TDuke94/plant-health-camera-hardware/kicad/csi-mux/csi-mux.kicad_sch

## KiCad design kicad/csi-mux/csi-mux.kicad_sch (2026-10-25)

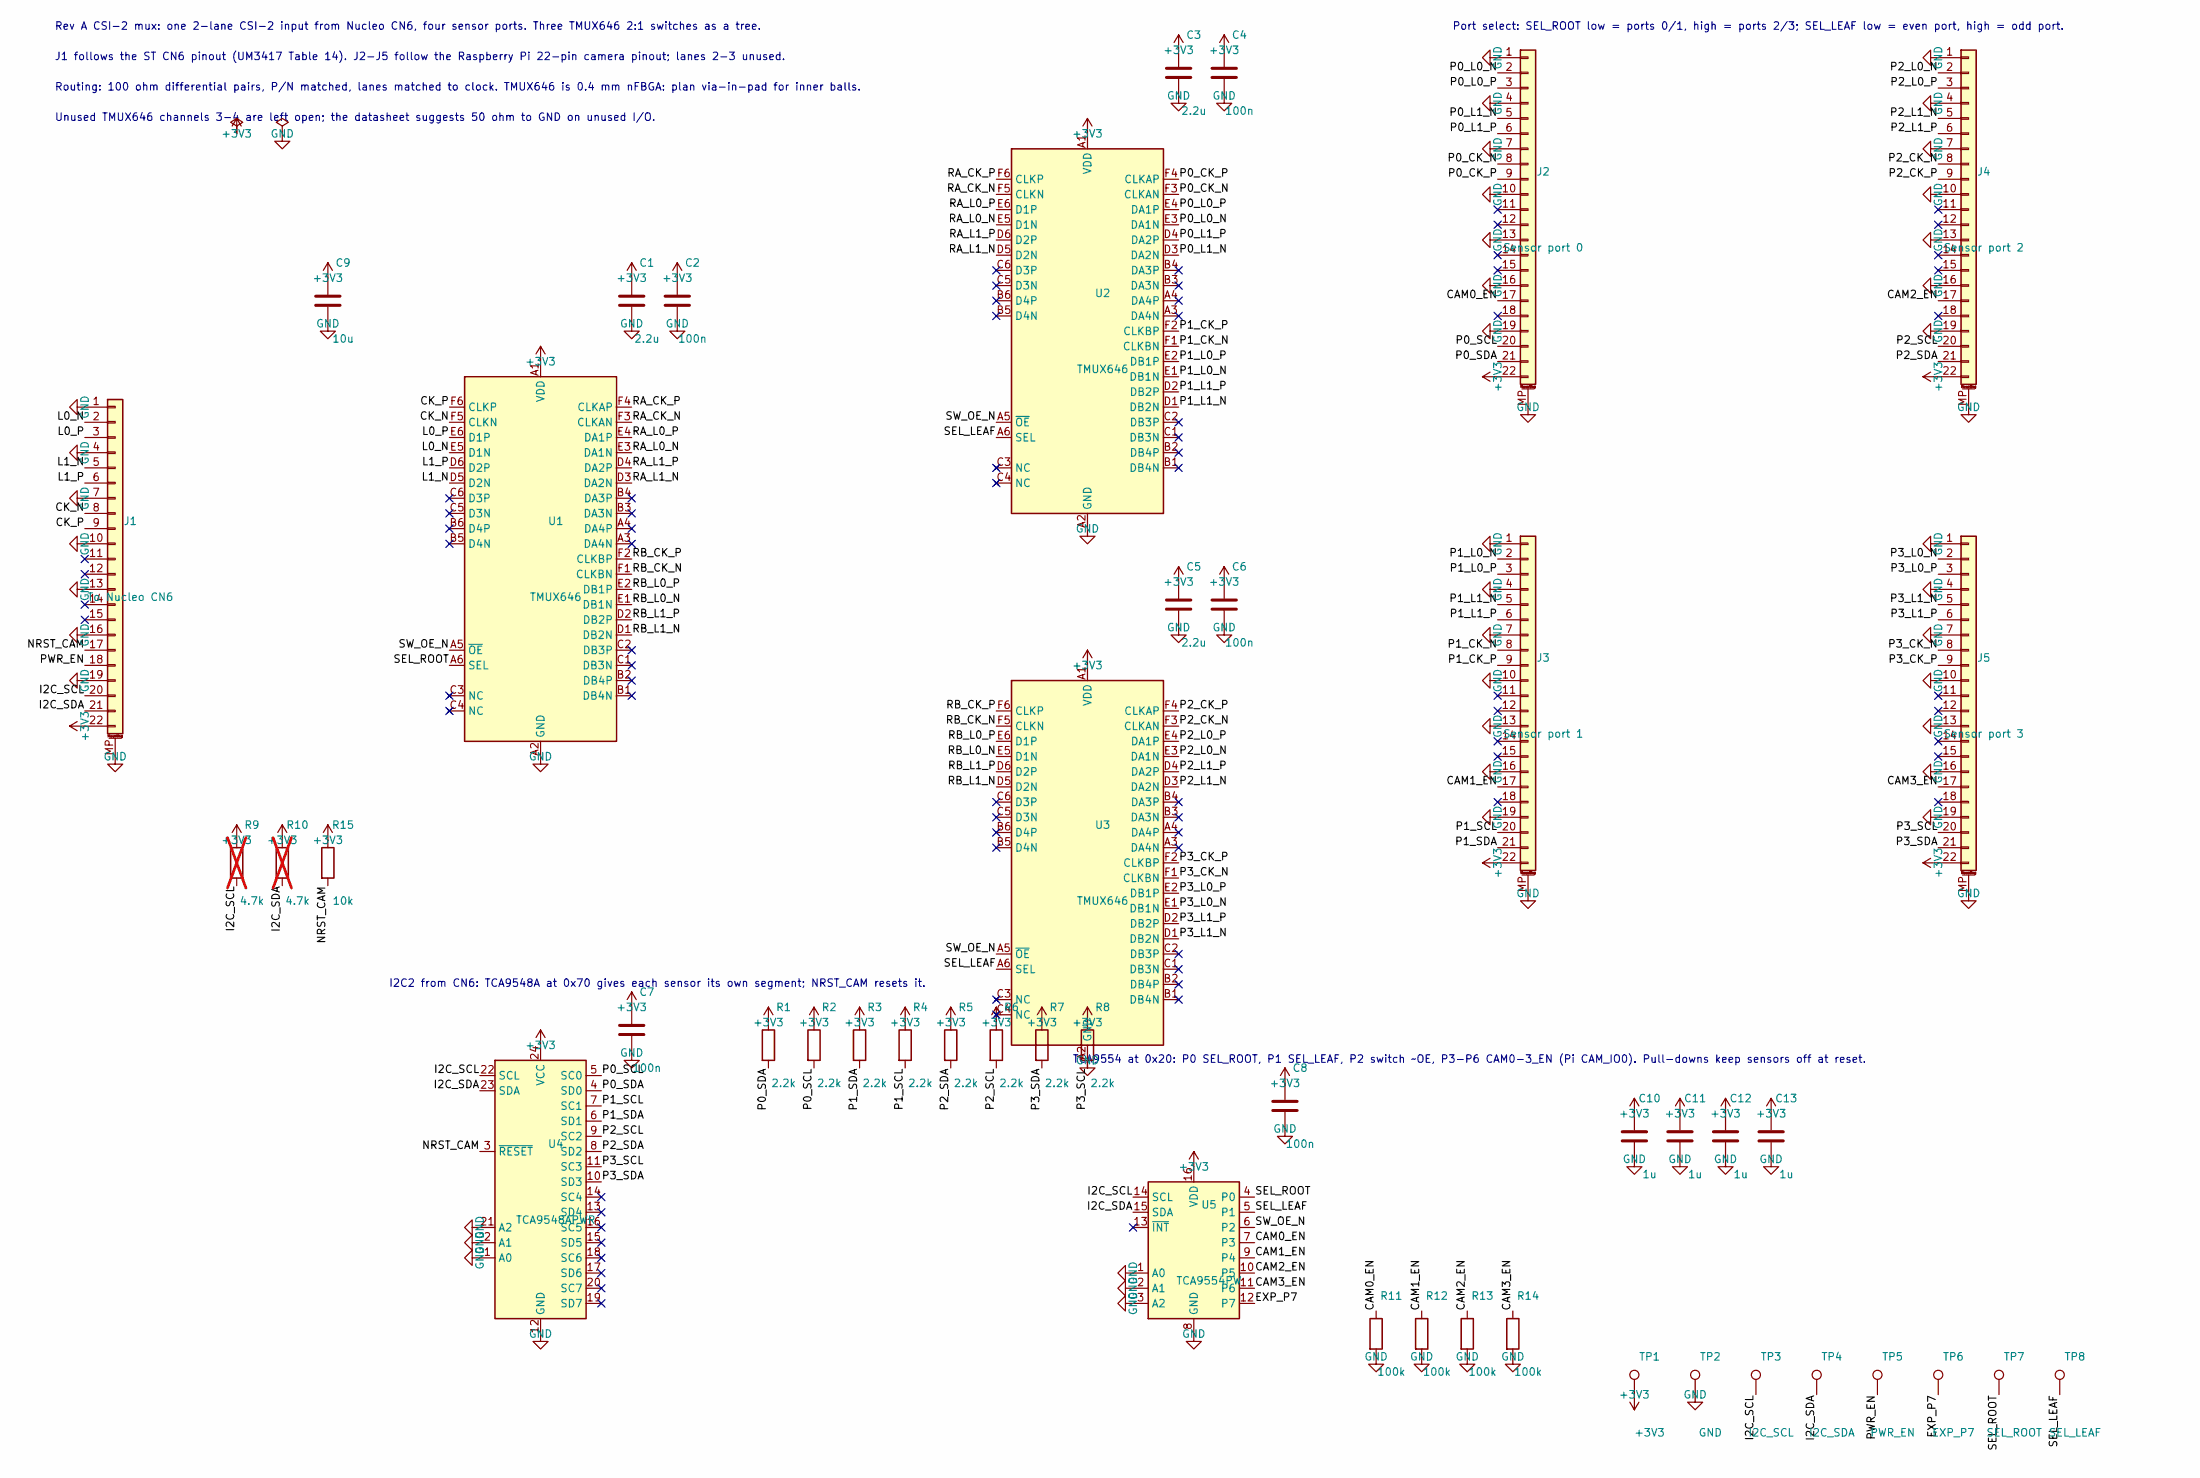
[picture p1: schematic csi-mux.kicad_sch]

Parts:
C1, C3, C5: 2.2u; C_0603_1608Metric
C2, C4, C6, C7, C8: 100n; C_0603_1608Metric
C9: 10u; C_0805_2012Metric
C10, C11, C12, C13: 1u; C_0603_1608Metric
J1: To Nucleo CN6; Hirose_FH12-22S-0.5SH_1x22-1MP_P0.50mm_Horizontal
J2: Sensor port 0; Hirose_FH12-22S-0.5SH_1x22-1MP_P0.50mm_Horizontal
J3: Sensor port 1; Hirose_FH12-22S-0.5SH_1x22-1MP_P0.50mm_Horizontal
J4: Sensor port 2; Hirose_FH12-22S-0.5SH_1x22-1MP_P0.50mm_Horizontal
J5: Sensor port 3; Hirose_FH12-22S-0.5SH_1x22-1MP_P0.50mm_Horizontal
R1, R2, R3, R4, R5, R6, R7, R8: 2.2k; R_0603_1608Metric
R9, R10: 4.7k; R_0603_1608Metric; not fitted
R11, R12, R13, R14: 100k; R_0603_1608Metric
R15: 10k; R_0603_1608Metric
TP1: +3V3; TestPoint_Pad_D1.5mm
TP2: GND; TestPoint_Pad_D1.5mm
TP3: I2C_SCL; TestPoint_Pad_D1.5mm
TP4: I2C_SDA; TestPoint_Pad_D1.5mm
TP5: PWR_EN; TestPoint_Pad_D1.5mm
TP6: EXP_P7; TestPoint_Pad_D1.5mm
TP7: SEL_ROOT; TestPoint_Pad_D1.5mm
TP8: SEL_LEAF; TestPoint_Pad_D1.5mm
U1, U2, U3: TMUX646; BGA-36_3.396x3.466mm_Layout6x6_P0.4mm_Ball0.25mm_Pad0.2mm_N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
U4: TCA9548APWR; TSSOP-24_4.4x7.8mm_P0.65mm
U5: TCA9554PW; TSSOP-16_4.4x5mm_P0.65mm

Connections:
+3V3: C1.1, C2.1, C3.1, C4.1, C5.1, C6.1, C7.1, C8.1, C9.1, C10.1, C11.1, C12.1, C13.1, J1.22, J2.22, J3.22, J4.22, J5.22, R1.1, R2.1, R3.1, R4.1, R5.1, R6.1, R7.1, R8.1, R9.1, R10.1, R15.1, TP1.1, U1.A1 (VDD), U2.A1 (VDD), U3.A1 (VDD), U4.24 (VCC), U5.16 (VDD)
CAM0_EN: J2.17, R11.1, U5.7 (P3)
CAM1_EN: J3.17, R12.1, U5.9 (P4)
CAM2_EN: J4.17, R13.1, U5.10 (P5)
CAM3_EN: J5.17, R14.1, U5.11 (P6)
CK_N: J1.8, U1.F5 (CLKN)
CK_P: J1.9, U1.F6 (CLKP)
EXP_P7: TP6.1, U5.12 (P7)
GND: C1.2, C2.2, C3.2, C4.2, C5.2, C6.2, C7.2, C8.2, C9.2, C10.2, C11.2, C12.2, C13.2, J1.1, J1.4, J1.7, J1.10, J1.13, J1.16, J1.19, J1.MP (MountPin), J2.1, J2.4, J2.7, J2.10, J2.13, J2.16, J2.19, J2.MP (MountPin), J3.1, J3.4, J3.7, J3.10, J3.13, J3.16, J3.19, J3.MP (MountPin), J4.1, J4.4, J4.7, J4.10, J4.13, J4.16, J4.19, J4.MP (MountPin), J5.1, J5.4, J5.7, J5.10, J5.13, J5.16, J5.19, J5.MP (MountPin), R11.2, R12.2, R13.2, R14.2, TP2.1, U1.A2 (GND), U2.A2 (GND), U3.A2 (GND), U4.1 (A0), U4.2 (A1), U4.12 (GND), U4.21 (A2), U5.1 (A0), U5.2 (A1), U5.3 (A2), U5.8 (GND)
I2C_SCL: J1.20, R9.2, TP3.1, U4.22 (SCL), U5.14 (SCL)
I2C_SDA: J1.21, R10.2, TP4.1, U4.23 (SDA), U5.15 (SDA)
L0_N: J1.2, U1.E5 (D1N)
L0_P: J1.3, U1.E6 (D1P)
L1_N: J1.5, U1.D5 (D2N)
L1_P: J1.6, U1.D6 (D2P)
NRST_CAM: J1.17, R15.2, U4.3 (~RESET)
P0_CK_N: J2.8, U2.F3 (CLKAN)
P0_CK_P: J2.9, U2.F4 (CLKAP)
P0_L0_N: J2.2, U2.E3 (DA1N)
P0_L0_P: J2.3, U2.E4 (DA1P)
P0_L1_N: J2.5, U2.D3 (DA2N)
P0_L1_P: J2.6, U2.D4 (DA2P)
P0_SCL: J2.20, R2.2, U4.5 (SC0)
P0_SDA: J2.21, R1.2, U4.4 (SD0)
P1_CK_N: J3.8, U2.F1 (CLKBN)
P1_CK_P: J3.9, U2.F2 (CLKBP)
P1_L0_N: J3.2, U2.E1 (DB1N)
P1_L0_P: J3.3, U2.E2 (DB1P)
P1_L1_N: J3.5, U2.D1 (DB2N)
P1_L1_P: J3.6, U2.D2 (DB2P)
P1_SCL: J3.20, R4.2, U4.7 (SC1)
P1_SDA: J3.21, R3.2, U4.6 (SD1)
P2_CK_N: J4.8, U3.F3 (CLKAN)
P2_CK_P: J4.9, U3.F4 (CLKAP)
P2_L0_N: J4.2, U3.E3 (DA1N)
P2_L0_P: J4.3, U3.E4 (DA1P)
P2_L1_N: J4.5, U3.D3 (DA2N)
P2_L1_P: J4.6, U3.D4 (DA2P)
P2_SCL: J4.20, R6.2, U4.9 (SC2)
P2_SDA: J4.21, R5.2, U4.8 (SD2)
P3_CK_N: J5.8, U3.F1 (CLKBN)
P3_CK_P: J5.9, U3.F2 (CLKBP)
P3_L0_N: J5.2, U3.E1 (DB1N)
P3_L0_P: J5.3, U3.E2 (DB1P)
P3_L1_N: J5.5, U3.D1 (DB2N)
P3_L1_P: J5.6, U3.D2 (DB2P)
P3_SCL: J5.20, R8.2, U4.11 (SC3)
P3_SDA: J5.21, R7.2, U4.10 (SD3)
PWR_EN: J1.18, TP5.1
RA_CK_N: U1.F3 (CLKAN), U2.F5 (CLKN)
RA_CK_P: U1.F4 (CLKAP), U2.F6 (CLKP)
RA_L0_N: U1.E3 (DA1N), U2.E5 (D1N)
RA_L0_P: U1.E4 (DA1P), U2.E6 (D1P)
RA_L1_N: U1.D3 (DA2N), U2.D5 (D2N)
RA_L1_P: U1.D4 (DA2P), U2.D6 (D2P)
RB_CK_N: U1.F1 (CLKBN), U3.F5 (CLKN)
RB_CK_P: U1.F2 (CLKBP), U3.F6 (CLKP)
RB_L0_N: U1.E1 (DB1N), U3.E5 (D1N)
RB_L0_P: U1.E2 (DB1P), U3.E6 (D1P)
RB_L1_N: U1.D1 (DB2N), U3.D5 (D2N)
RB_L1_P: U1.D2 (DB2P), U3.D6 (D2P)
SEL_LEAF: TP8.1, U2.A6 (SEL), U3.A6 (SEL), U5.5 (P1)
SEL_ROOT: TP7.1, U1.A6 (SEL), U5.4 (P0)
SW_OE_N: U1.A5 (~OE), U2.A5 (~OE), U3.A5 (~OE), U5.6 (P2)

Notes on the sheet:
Rev A CSI-2 mux: one 2-lane CSI-2 input from Nucleo CN6, four sensor ports. Three TMUX646 2:1 switches as a tree.
J1 follows the ST CN6 pinout (UM3417 Table 14). J2-J5 follow the Raspberry Pi 22-pin camera pinout; lanes 2-3 unused.
Routing: 100 ohm differential pairs, P/N matched, lanes matched to clock. TMUX646 is 0.4 mm nFBGA: plan via-in-pad for inner balls.
Unused TMUX646 channels 3-4 are left open; the datasheet suggests 50 ohm to GND on unused I/O.
I2C2 from CN6: TCA9548A at 0x70 gives each sensor its own segment; NRST_CAM resets it.
TCA9554 at 0x20: P0 SEL_ROOT, P1 SEL_LEAF, P2 switch ~OE, P3-P6 CAM0-3_EN (Pi CAM_IO0). Pull-downs keep sensors off at reset.
Port select: SEL_ROOT low = ports 0/1, high = ports 2/3; SEL_LEAF low = even port, high = odd port.
