TDuke94/plant-health-camera-hardware/kicad/shield/shield.kicad_sch

## KiCad design kicad/shield/shield.kicad_sch (2026-10-25)

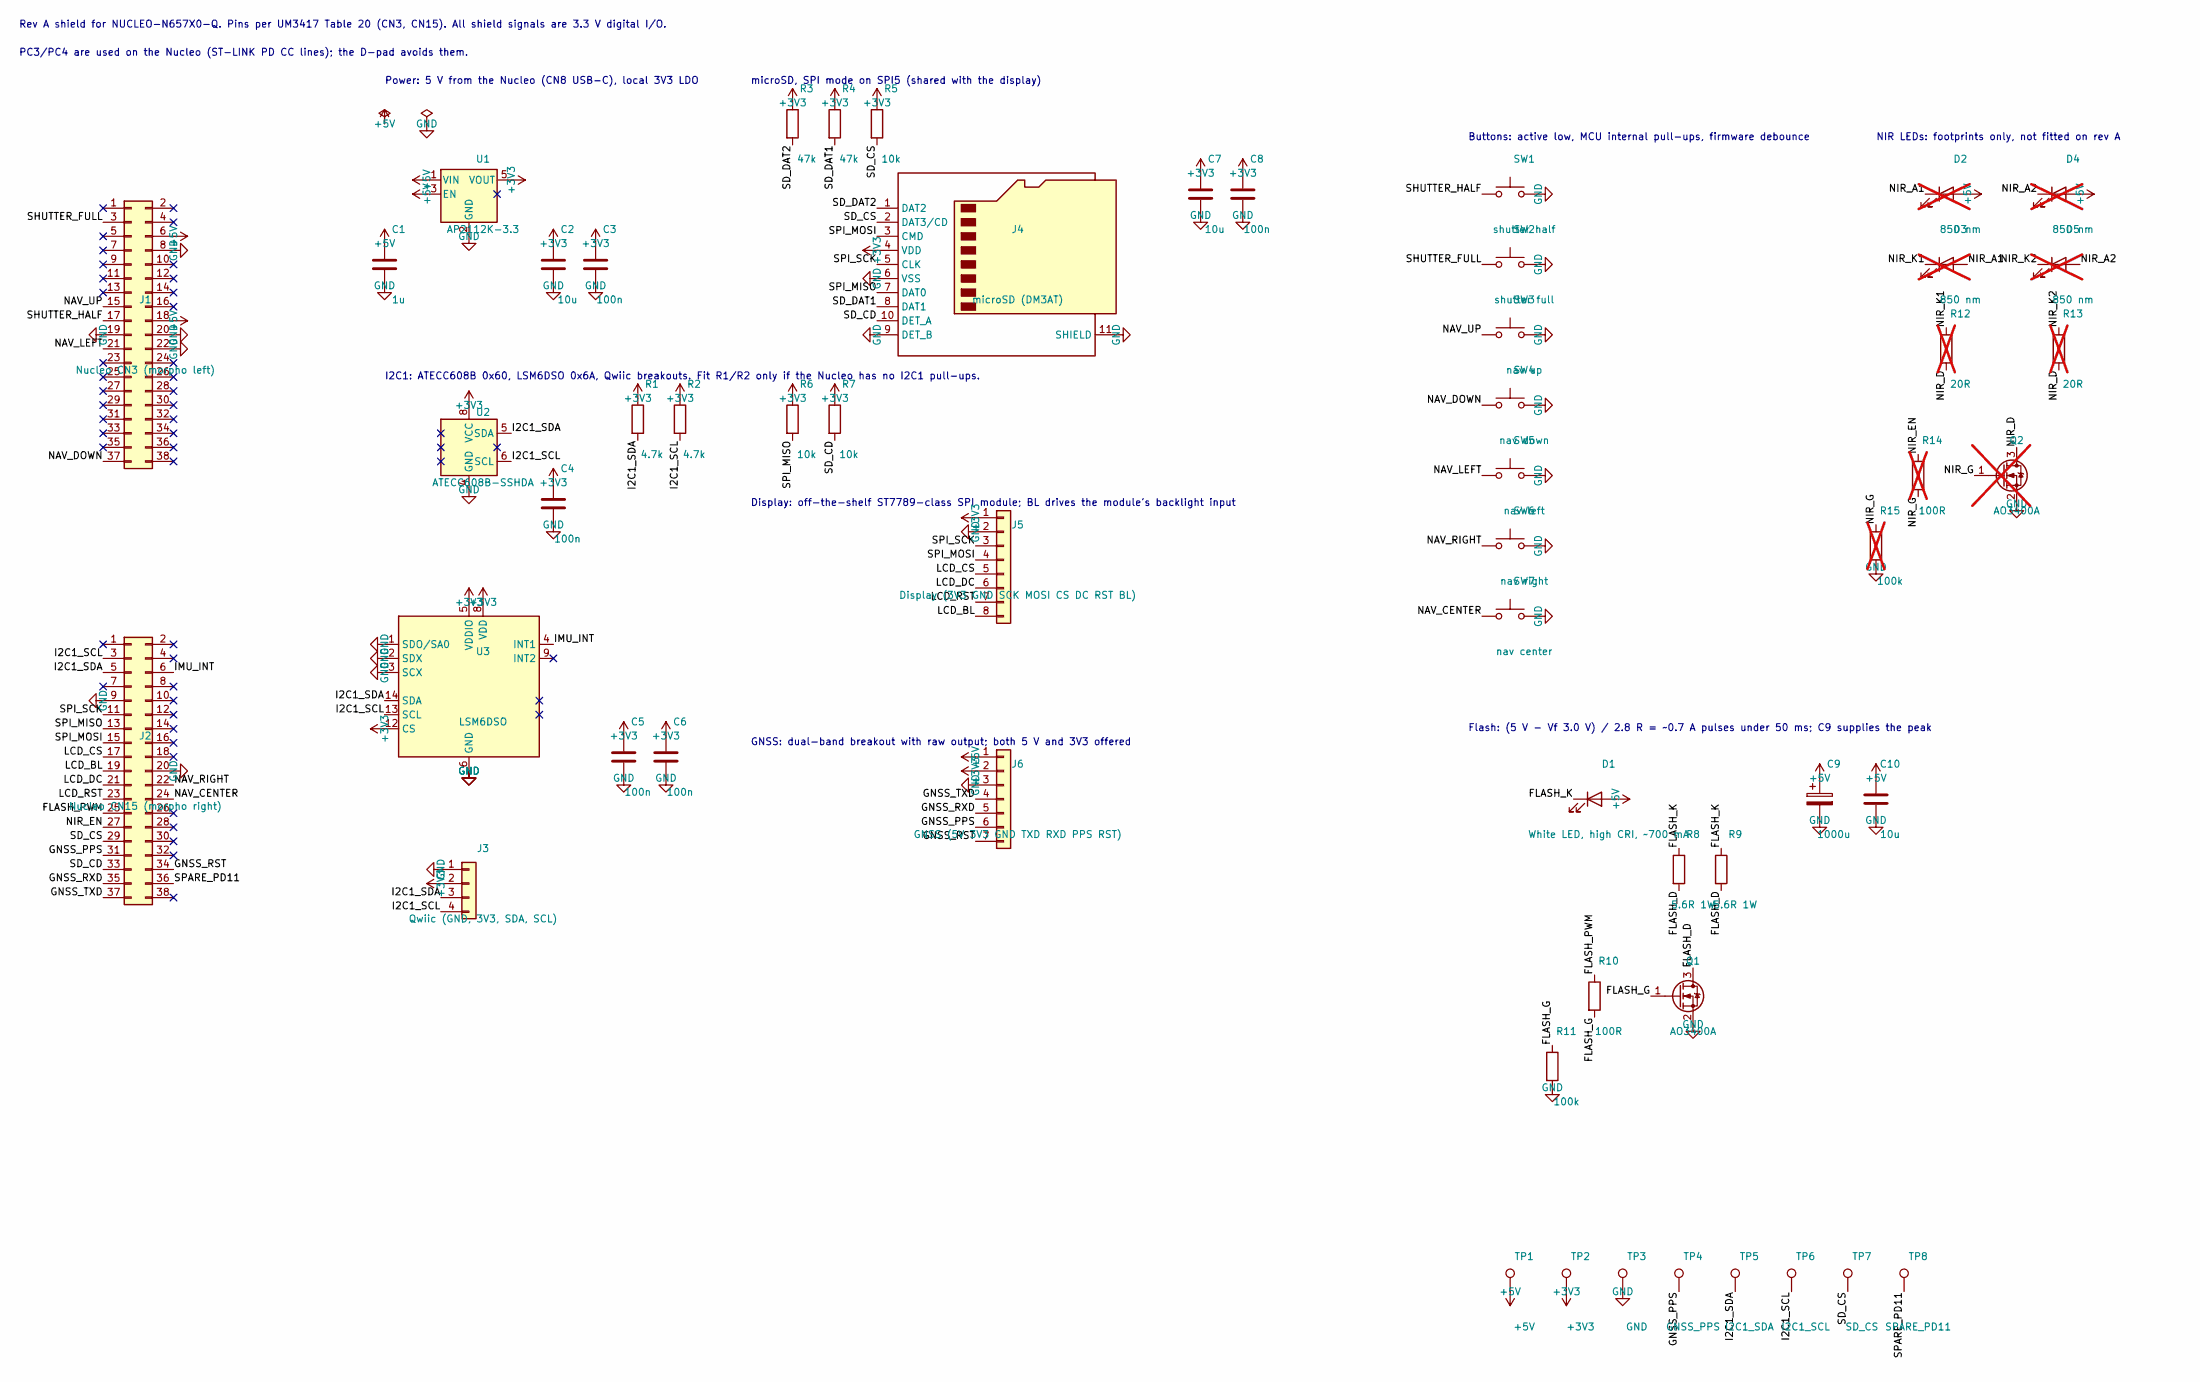
[picture p2: schematic shield.kicad_sch]

Parts:
C1: 1u; C_0603_1608Metric
C2, C7, C10: 10u; C_0805_2012Metric
C3, C4, C5, C6, C8: 100n; C_0603_1608Metric
C9: 1000u; CP_Radial_D10.0mm_P5.00mm
D1: White LED, high CRI, ~700 mA; LED_Cree-XP
D2, D3, D4, D5: 850 nm; LED_1206_3216Metric; not fitted
J1: Nucleo CN3 (morpho left); PinSocket_2x19_P2.54mm_Vertical
J2: Nucleo CN15 (morpho right); PinSocket_2x19_P2.54mm_Vertical
J3: Qwiic (GND, 3V3, SDA, SCL); JST_SH_SM04B-SRSS-TB_1x04-1MP_P1.00mm_Horizontal
J4: microSD (DM3AT); microSD_HC_Hirose_DM3AT-SF-PEJM5
J5: Display (3V3 GND SCK MOSI CS DC RST BL); PinSocket_1x08_P2.54mm_Vertical
J6: GNSS (5V 3V3 GND TXD RXD PPS RST); PinSocket_1x07_P2.54mm_Vertical
Q1: AO3400A; SOT-23
Q2: AO3400A; SOT-23; not fitted
R1, R2: 4.7k; R_0603_1608Metric
R3, R4: 47k; R_0603_1608Metric
R5, R6, R7: 10k; R_0603_1608Metric
R8, R9: 5.6R 1W; R_2512_6332Metric
R10: 100R; R_0603_1608Metric
R11: 100k; R_0603_1608Metric
R12, R13: 20R; R_0603_1608Metric; not fitted
R14: 100R; R_0603_1608Metric; not fitted
R15: 100k; R_0603_1608Metric; not fitted
SW1: shutter half; SW_SPST_TL3342
SW2: shutter full; SW_SPST_TL3342
SW3: nav up; SW_SPST_TL3342
SW4: nav down; SW_SPST_TL3342
SW5: nav left; SW_SPST_TL3342
SW6: nav right; SW_SPST_TL3342
SW7: nav center; SW_SPST_TL3342
TP1: +5V; TestPoint_Pad_D1.5mm
TP2: +3V3; TestPoint_Pad_D1.5mm
TP3: GND; TestPoint_Pad_D1.5mm
TP4: GNSS_PPS; TestPoint_Pad_D1.5mm
TP5: I2C1_SDA; TestPoint_Pad_D1.5mm
TP6: I2C1_SCL; TestPoint_Pad_D1.5mm
TP7: SD_CS; TestPoint_Pad_D1.5mm
TP8: SPARE_PD11; TestPoint_Pad_D1.5mm
U1: AP2112K-3.3; SOT-23-5
U2: ATECC608B-SSHDA; SOIC-8_3.9x4.9mm_P1.27mm
U3: LSM6DSO; LGA-14_3x2.5mm_P0.5mm_LayoutBorder3x4y

Connections:
+3V3: C2.1, C3.1, C4.1, C5.1, C6.1, C7.1, C8.1, J3.2, J4.4 (VDD), J5.1, J6.2, R1.1, R2.1, R3.1, R4.1, R5.1, R6.1, R7.1, TP2.1, U1.5 (VOUT), U2.8 (VCC), U3.5 (VDDIO), U3.8 (VDD), U3.12 (CS)
+5V: C1.1, C9.1, C10.1, D1.2 (A), D2.2 (A), D4.2 (A), J1.6, J1.18, J6.1, TP1.1, U1.1 (VIN), U1.3 (EN)
FLASH_D: Q1.3 (D), R8.2, R9.2
FLASH_G: Q1.1 (G), R10.2, R11.1
FLASH_K: D1.1 (K), R8.1, R9.1
FLASH_PWM: J2.25, R10.1
GND: C1.2, C2.2, C3.2, C4.2, C5.2, C6.2, C7.2, C8.2, C9.2, C10.2, J1.8, J1.19, J1.20, J1.22, J2.9, J2.20, J3.1, J4.6 (VSS), J4.9 (DET_B), J4.11 (SHIELD), J5.2, J6.3, Q1.2 (S), Q2.2 (S), R11.2, R15.2, SW1.2, SW2.2, SW3.2, SW4.2, SW5.2, SW6.2, SW7.2, TP3.1, U1.2 (GND), U2.4 (GND), U3.1 (SDO/SA0), U3.2 (SDX), U3.3 (SCX), U3.6 (GND), U3.7 (GND)
GNSS_PPS: J2.31, J6.6, TP4.1
GNSS_RST: J2.34, J6.7
GNSS_RXD: J2.35, J6.5
GNSS_TXD: J2.37, J6.4
I2C1_SCL: J2.3, J3.4, R2.2, TP6.1, U2.6 (SCL), U3.13 (SCL)
I2C1_SDA: J2.5, J3.3, R1.2, TP5.1, U2.5 (SDA), U3.14 (SDA)
IMU_INT: J2.6, U3.4 (INT1)
LCD_BL: J2.19, J5.8
LCD_CS: J2.17, J5.5
LCD_DC: J2.21, J5.6
LCD_RST: J2.23, J5.7
NAV_CENTER: J2.24, SW7.1
NAV_DOWN: J1.37, SW4.1
NAV_LEFT: J1.21, SW5.1
NAV_RIGHT: J2.22, SW6.1
NAV_UP: J1.15, SW3.1
NIR_A1: D2.1 (K), D3.2 (A)
NIR_A2: D4.1 (K), D5.2 (A)
NIR_D: Q2.3 (D), R12.2, R13.2
NIR_EN: J2.27, R14.1
NIR_G: Q2.1 (G), R14.2, R15.1
NIR_K1: D3.1 (K), R12.1
NIR_K2: D5.1 (K), R13.1
SD_CD: J2.33, J4.10 (DET_A), R7.2
SD_CS: J2.29, J4.2 (DAT3/CD), R5.2, TP7.1
SD_DAT1: J4.8 (DAT1), R4.2
SD_DAT2: J4.1 (DAT2), R3.2
SHUTTER_FULL: J1.3, SW2.1
SHUTTER_HALF: J1.17, SW1.1
SPARE_PD11: J2.36, TP8.1
SPI_MISO: J2.13, J4.7 (DAT0), R6.2
SPI_MOSI: J2.15, J4.3 (CMD), J5.4
SPI_SCK: J2.11, J4.5 (CLK), J5.3

Notes on the sheet:
Rev A shield for NUCLEO-N657X0-Q. Pins per UM3417 Table 20 (CN3, CN15). All shield signals are 3.3 V digital I/O.
PC3/PC4 are used on the Nucleo (ST-LINK PD CC lines); the D-pad avoids them.
Power: 5 V from the Nucleo (CN8 USB-C), local 3V3 LDO
I2C1: ATECC608B 0x60, LSM6DSO 0x6A, Qwiic breakouts. Fit R1/R2 only if the Nucleo has no I2C1 pull-ups.
microSD, SPI mode on SPI5 (shared with the display)
Display: off-the-shelf ST7789-class SPI module; BL drives the module's backlight input
GNSS: dual-band breakout with raw output; both 5 V and 3V3 offered
Buttons: active low, MCU internal pull-ups, firmware debounce
Flash: (5 V - Vf 3.0 V) / 2.8 R = ~0.7 A pulses under 50 ms; C9 supplies the peak
NIR LEDs: footprints only, not fitted on rev A
