TDuke94/plant-health-camera-hardware/(commit log)

2026-10-25 Add rev A hardware spec and review checklist
    Rev A is a shield for the NUCLEO-N657X0-Q plus a CSI-2 mux board on
    the Nucleo's camera FPC. The spec covers the Nucleo's limits (no PSRAM),
    block allocation, pin budget, power, a first-pass BOM, the mux board and
    open items. The checklist gives yes/no review steps and kicad-cli CI.
2026-10-25 Remove site-specific references from docs
    Drop the garden and barn references and the private design-doc link so
    the docs describe the camera without naming a particular site.
2026-10-25 Add rev A shield schematic and verified pin table
    The shield schematic covers the morpho connectors, 3V3 LDO, secure
    element, IMU, Qwiic, microSD, display and GNSS headers, buttons, the
    white flash driver and the unfitted NIR LEDs.
    Pins now come from UM3417 Table 20. PC3 and PC4 are used by the
    Nucleo's ST-LINK PD lines and PC9 is not on the headers, so the D-pad
    moves to PC5, PC8, PE4, PE7 and PE1. The flash driver becomes a
    low-side MOSFET with a resistor current limit, and the BOM matches the
    schematic references.
    [shield.kicad_sch]
2026-10-25 Add rev A CSI-2 mux board schematic
    Three TMUX646 switches in a tree, a TCA9548A I2C mux and a TCA9554
    expander, all controlled over the Nucleo CN6 I2C2. Four ports in the
    Raspberry Pi 22-pin pinout. Updates the spec's mux section to match.
    [csi-mux.kicad_sch]
